Ganghyeok-Lim/Proj-ZYNQ-7000_SOM_Bd/Rev_A/01_HW/0. Fab Files/BOM/ZYNQ_SOM_Bd_BOM_240518.xlsx

Comment | Description | Designator | Quantity | LCSC Part #
470nF/6.3V/0603 | 6.3V 470nF X5R ±10% 0201 Multilayer Ceramic Capacitors MLCC - SMD/SMT ROHS | C300, C302, C303, C306, C307, C308, C313, C314, C315, C316, C319, C320, C321, C322, C327, C328, C333, C338, C339, C340, C341, C342, C343, C344, C345, C704, C705, C706, C707, C803, C814, C827, C838 | 33 | C85926
4.7uF/10V/1005 | 10V 4.7uF X5R ±20% 0402 Multilayer Ceramic Capacitors MLCC - SMD/SMT ROHS | C301, C305, C309, C312, C317, C323, C326, C329, C332, C336, C337, C346, C347, C505, C601, C708, C709, C710, C711, C713, C717, C718, C719, C802, C813, C826, C837 | 27 | C23733
100uF/6.3V/3216 | Ceramic CAP_100uF/6.3V/3216 | C304, C310, C311, C318, C324, C325, C330, C331, C334, C335, C348 | 11 | C15008
100nF/16V/1005 | Ceramic CAP_100nF/16V/1005 | C400, C401, C500, C501, C502, C503, C504, C600 | 8 | C1525
47nF/16V/0603 | 16V 47nF X5R ±10% 0201 Multilayer Ceramic Capacitors MLCC - SMD/SMT ROHS | C700, C701, C702, C703, C715, C716, C800, C801, C804, C805, C806, C807, C808, C809, C810, C811, C812, C815, C816, C817, C818, C819, C820, C821, C822, C823, C824, C825, C828, C829, C830, C831, C832, C833, C834, C835, C836, C839, C840, C841, C842, C843, C844, C845, C846, C847 | 46 | C88917
22uF/25V/2012 | Ceramic CAP_22uF/25V/2012 | C712, C714 | 2 | C45783
100nF/50V/1608 | Ceramic CAP_100nF/50V/1608 | C901, C903, C905, C907, C913 | 5 | C14663
10uF/25V/1608 | Ceramic CAP_10uF/25V/1608 | C908, C909, C910, C911, C914 | 5 | C96446
TC2070-IDC | TC2070 14-pin Plug-of-Nails™ (with legs) to 14 pin 2mm female IDC connector. | CN400 | 1
EDGE-CONNECTOR_SODIMM-260P | EDGE-CONNECTOR_DDR4-SODIMM-260P | CN900 | 1
CG0402MLU-3.3G | Varistor 1 Circuit Surface Mount, MLCV 0402 (1005 Metric) | ESD400, ESD401, ESD402, ESD403 | 4 | C2655393
BLM15PX121SN1D | 55mΩ ±25% 120Ω@100MHz 0402 Ferrite Beads ROHS | FB300 | 1 | C88970
GREEN/2012 | Colorless transparence -30℃~+85℃ Positive post Common anode RGB 120° 0805 Light Emitting Diodes (LED) ROHS | LED400, LED900 | 2 | C2962094
RGB/2012 | Colorless transparence -30℃~+85℃ Positive post Common anode RGB 120° 0805 Light Emitting Diodes (LED) ROHS | LED501, LED600 | 2 | C2962094
2N7002 | 60V 115mA 200mW 7.5Ω@10V,500mA N Channel SOT-23 MOSFETs ROHS | Q400 | 1 | C8545
4.7K/1005 | RES_4.7K/1005/62.5mW | R400, R401, R402, R403, R404, R505, R726 | 7 | C25900
22R/1005 | RES_22R/1005/62.5mW | R405, R406, R407, R408, R500, R502, R600 | 7 | C25092
510R/1005 | RES_510R/1005/62.5mW | R409, R910 | 2 | C25123
0R/1608/NC | 0R/1608/0.1W/NC | R410, R411 | 2
20K/1005 | RES_20K/1005/62.5mW | R412, R413, R414, R415, R416, R513, R515 | 7 | C25765
1K/1608 | RES_1K/1608/0.1W | R417, R418 | 2 | C21190
1K/1005 | RES_1K/1005/62.5mW | R419, R420, R421, R604, R728 | 5 | C11702
12K/1005 | RES_12K/1005/62.5mW | R422, R501, R504, R725 | 4 | C25752
120R/1005 | RES_120R/1005/62.5mW | R503 | 1 | C25079
470R/1005 | RES_470R/1005/62.5mW | R508, R510, R512, R601, R602, R603 | 6 | C25117
0R/1005/NC | RES_0R/1005/62.5mW/NC | R509 | 1
20K/1005/NC | RES_20K/1005/62.5mW/NC | R511, R514 | 2
100R/1005 | RES_100R/1005/62.5mW | R700, R727, R729 | 3 | C25076
49.9R/1005 | RES_49.9R/1005/62.5mW | R701, R702, R703, R704, R705, R706, R707, R708, R709, R710, R711, R712, R713, R714, R715, R716, R717, R718, R719, R720, R721, R722, R723, R724 | 24 | C25120
100K/1005 | RES_100K/1005/62.5mW | R730 | 1 | C25741
240R/1608 | RES_240R/1608/0.1W | R800, R801 | 2 | C23350
0R/1005 | RES_0R/1005/62.5mW | R900, R901, R902, R903, R904, R905, R906, R907, R908, R909 | 10 | C17168
TS-1088-AR02016 | NO 50mA 100MΩ 100000 Times 12V 160gf@±50gf Brick nogging SPST SMD Tactile Switches ROHS | SW400, SW500 | 2 | C720477
DSHP04TS-S | 4Bit SPST 24V 25mA Black 3千次 Slide (Standard),凹槽式 SMD-8P,5.4x6.7mm DIP Switches ROHS | SW401 | 1 | C319050
XC7Z010-1CLG400I | Dual ARM® Cortex®-A9 MPCore™ with CoreSight™ System On Chip (SOC) IC Zynq®-7000 Artix™-7 FPGA, 28K Logic Cells 766MHz 400-CSPBGA (17x17) | U300 | 1 | C2840994
W25Q128JVEIQ | 3V 128M-BIT SERIAL FLASH MEMORY WITH DUAL/QUAD SPI & QPI & DTR WSON-8 | U500 | 1 | C401662
SN74LVC1G07DBVT | Single Buffer/Driver With Open-Drain Output / IC BUF NON-INVERT 5.5V SOT23-5 | U502 | 1 | C2867373
BD3539FVM-TR | 1.0V to 5.5V, 1A 1ch Termination Regulators for DDR-SDRAMs, 8-MSOP | U701 | 1 | C213437
MT41K256M16TW-107 IT:P | SDRAM - DDR3L Memory IC 4Gbit Parallel 933 MHz 20 ns 96-FBGA (8x14) | U800, U801 | 2 | C367428
S2D33.333300B20F30T(33.33MHz) | 3.3V ±20ppm CMOS 33.3333MHz SMD2520-4P Oscillators ROHS | X500 | 1 | C907622
S2D50.000000B20F30T(50MHz) | 3.3V 20mA ±30ppm CMOS 50MHz SMD2520-4P Oscillators ROHS | X600 | 1 | C907626
