Ganghyeok-Lim/Proj-ZYNQ-7000_SOM_Bd/Rev_A/01_HW/ZYNQ-7000 SOM Bd/ZYNQ-7000 SOM Bd.pdf

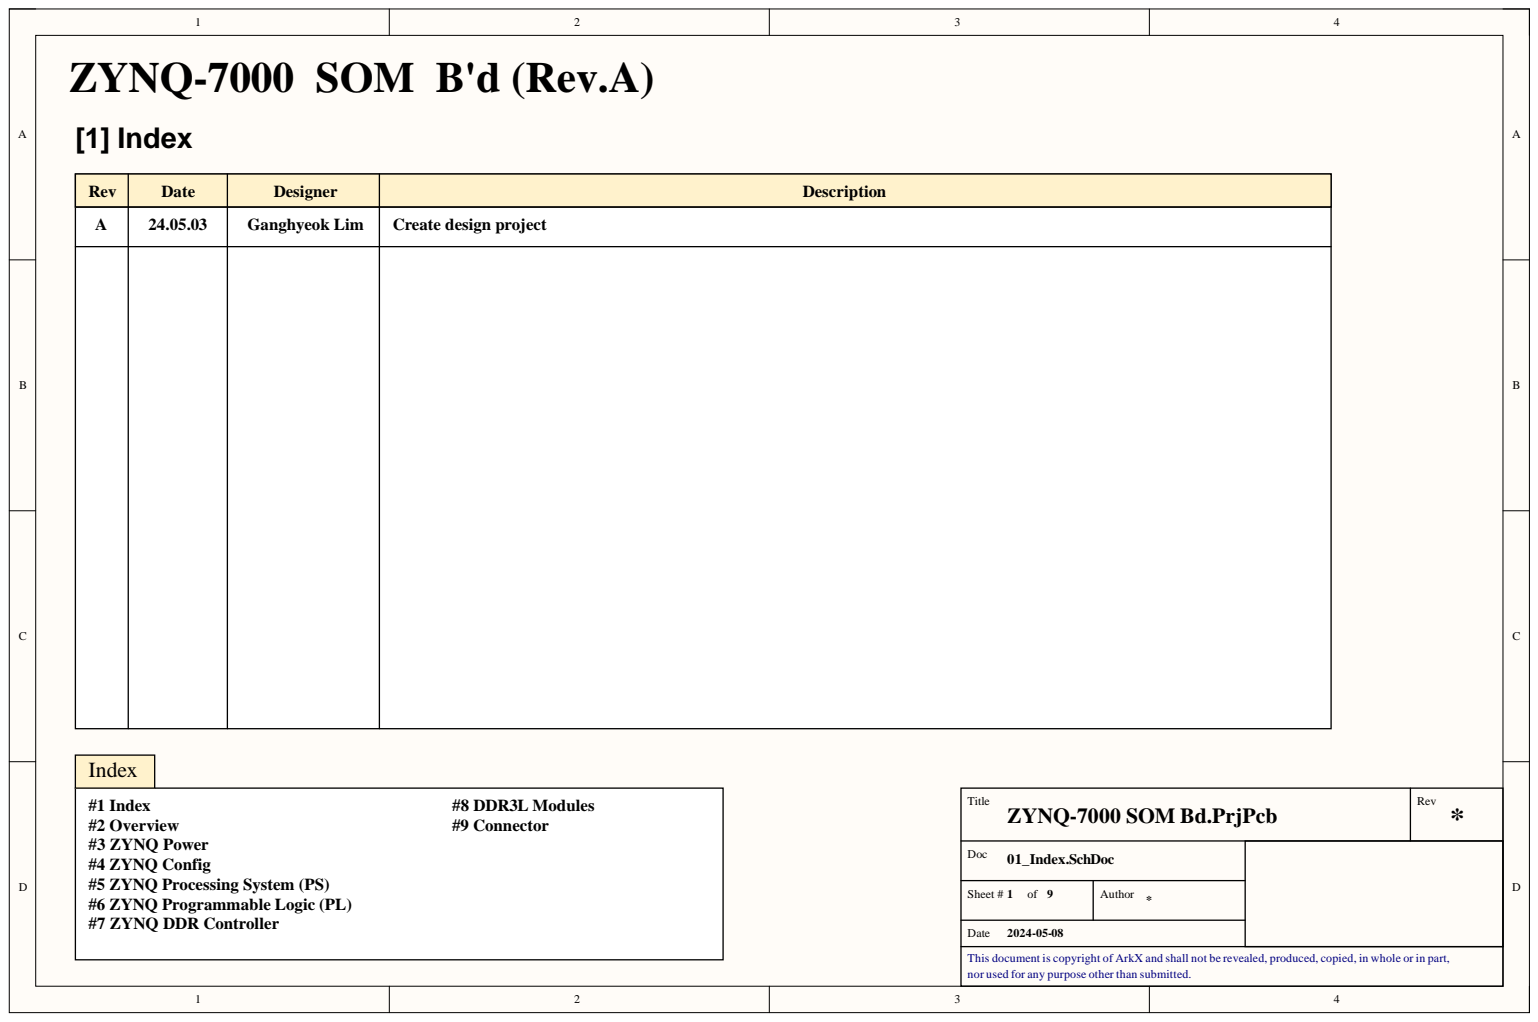
[picture p1: page 1]

Rev | Date | Designer | Description

A | 24.05.03 | Ganghyeok Lim | Create design project

#1 Index
#2 Overview
#3 ZYNQ Power
#4 ZYNQ Config
#5 ZYNQ Processing System (PS)
#6 ZYNQ Programmable Logic (PL)
#7 ZYNQ DDR Controller

Doc 01_Index.SchDoc

Sheet # 1 of 9 | Author *

This document is copyright of ArkX and shall not be revealed, produced, copied, in whole or in part,
nor used for any purpose other than submitted.

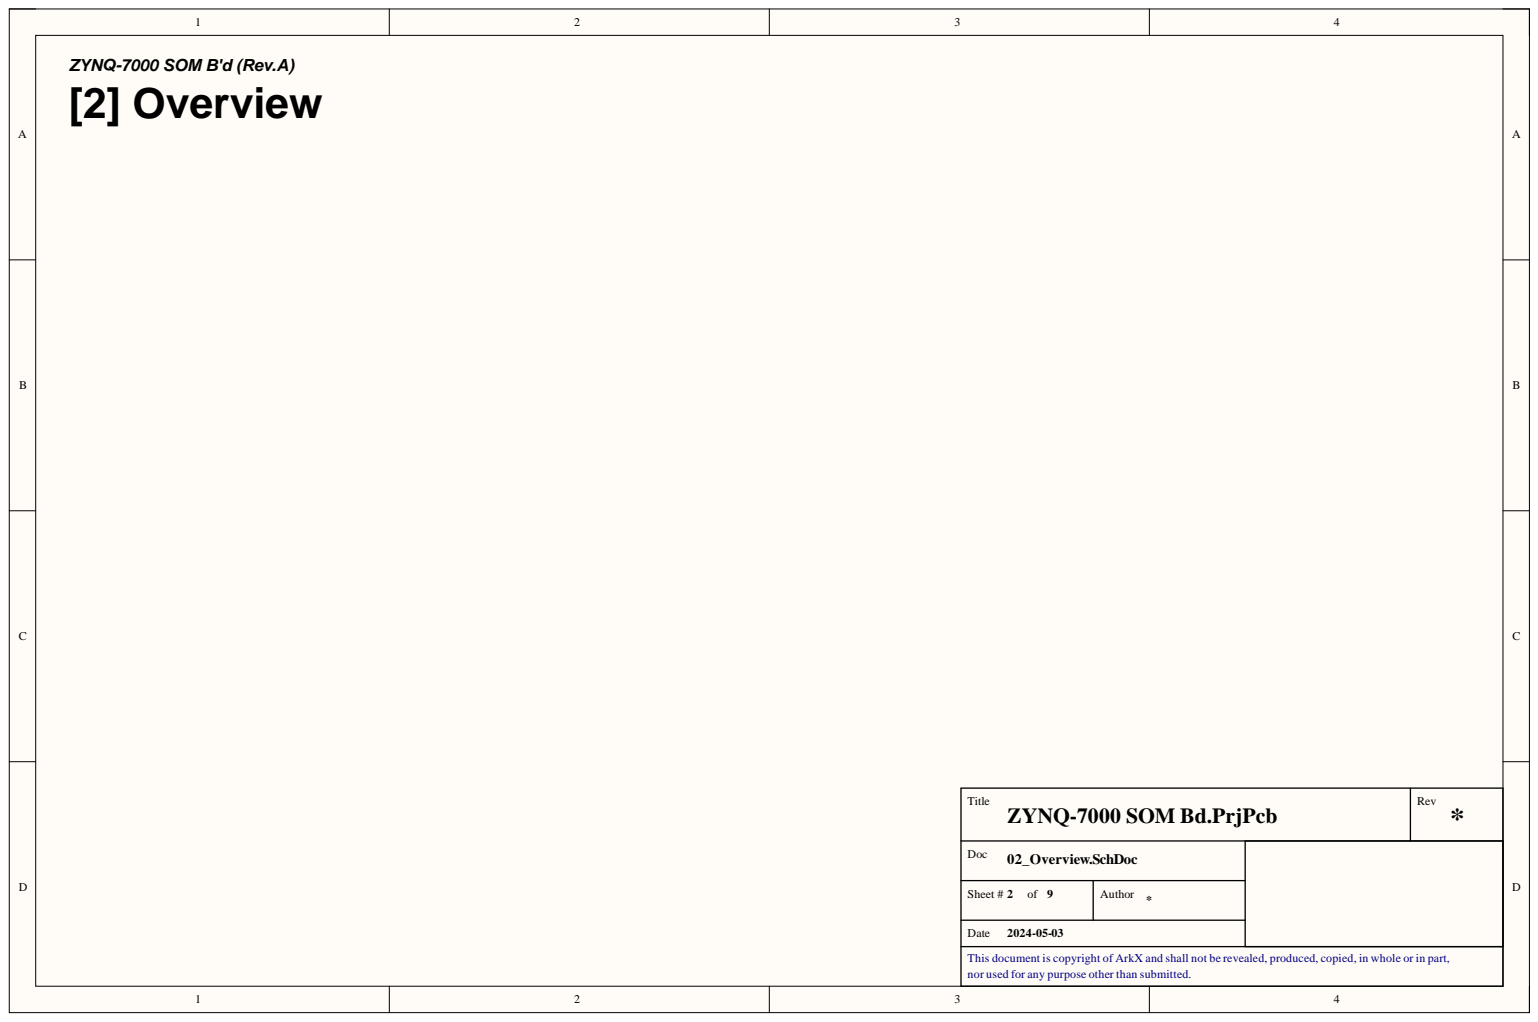
[picture p2: page 2]

Title ZYNQ-7000 SOM Bd.PrjPcb | Rev *

Doc 02_Overview.SchDoc

Sheet # 2 of 9 | Author *

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

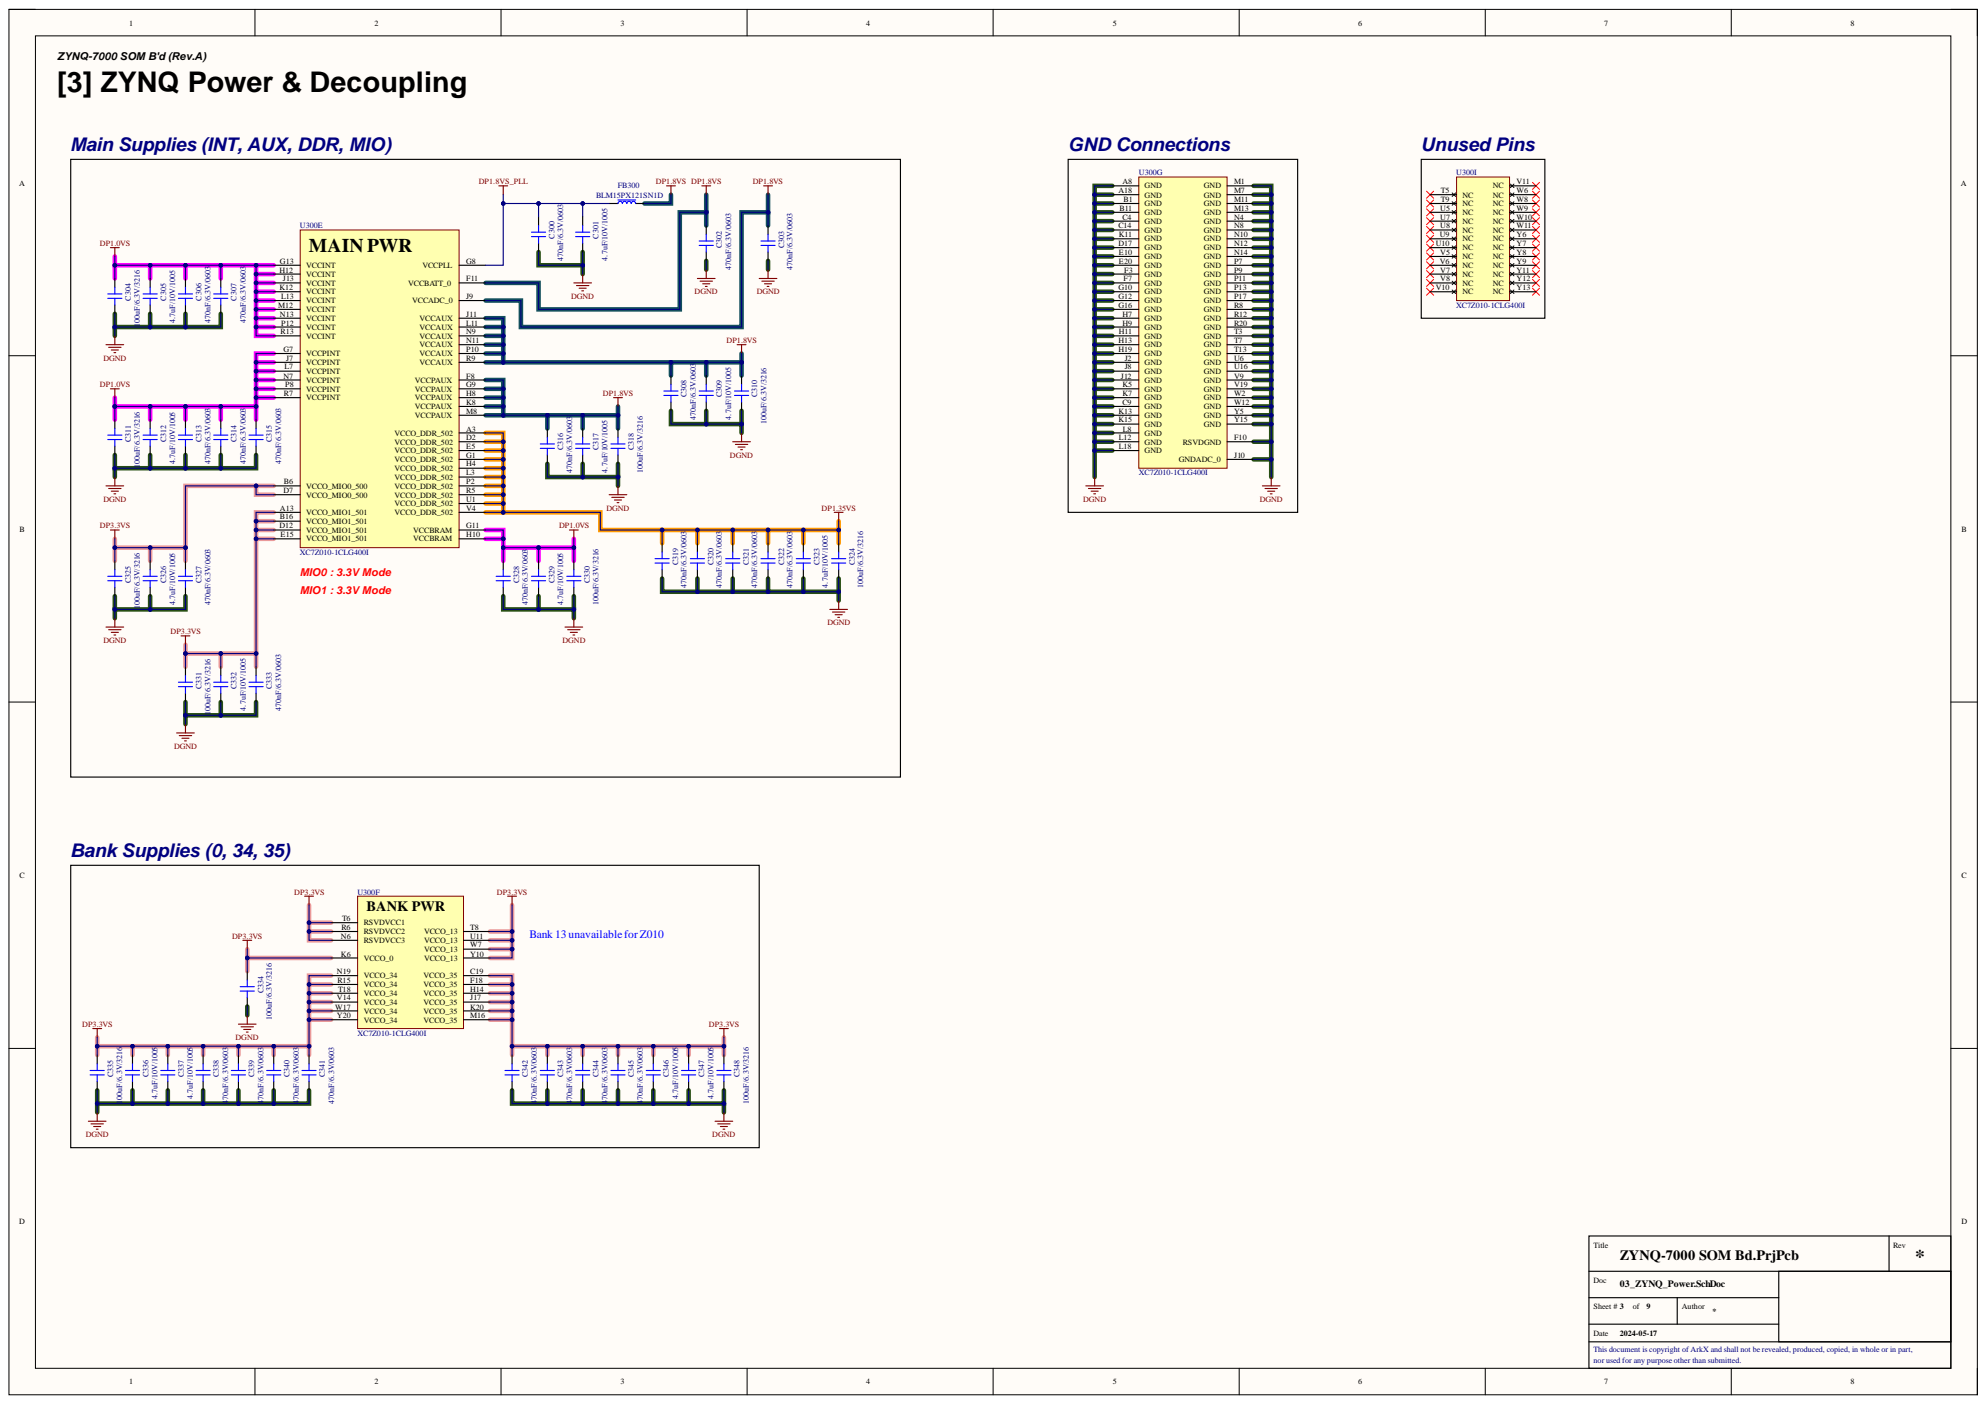
[picture p3: page 3]

Main Supplies (INT, AUX, DDR, MIO)

Title ZYNQ-7000 SOM Bd.PrjPcb | Rev *

Doc 03_ZYNQ_Power.SchDoc

Sheet # 3 of 9 | Author *

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

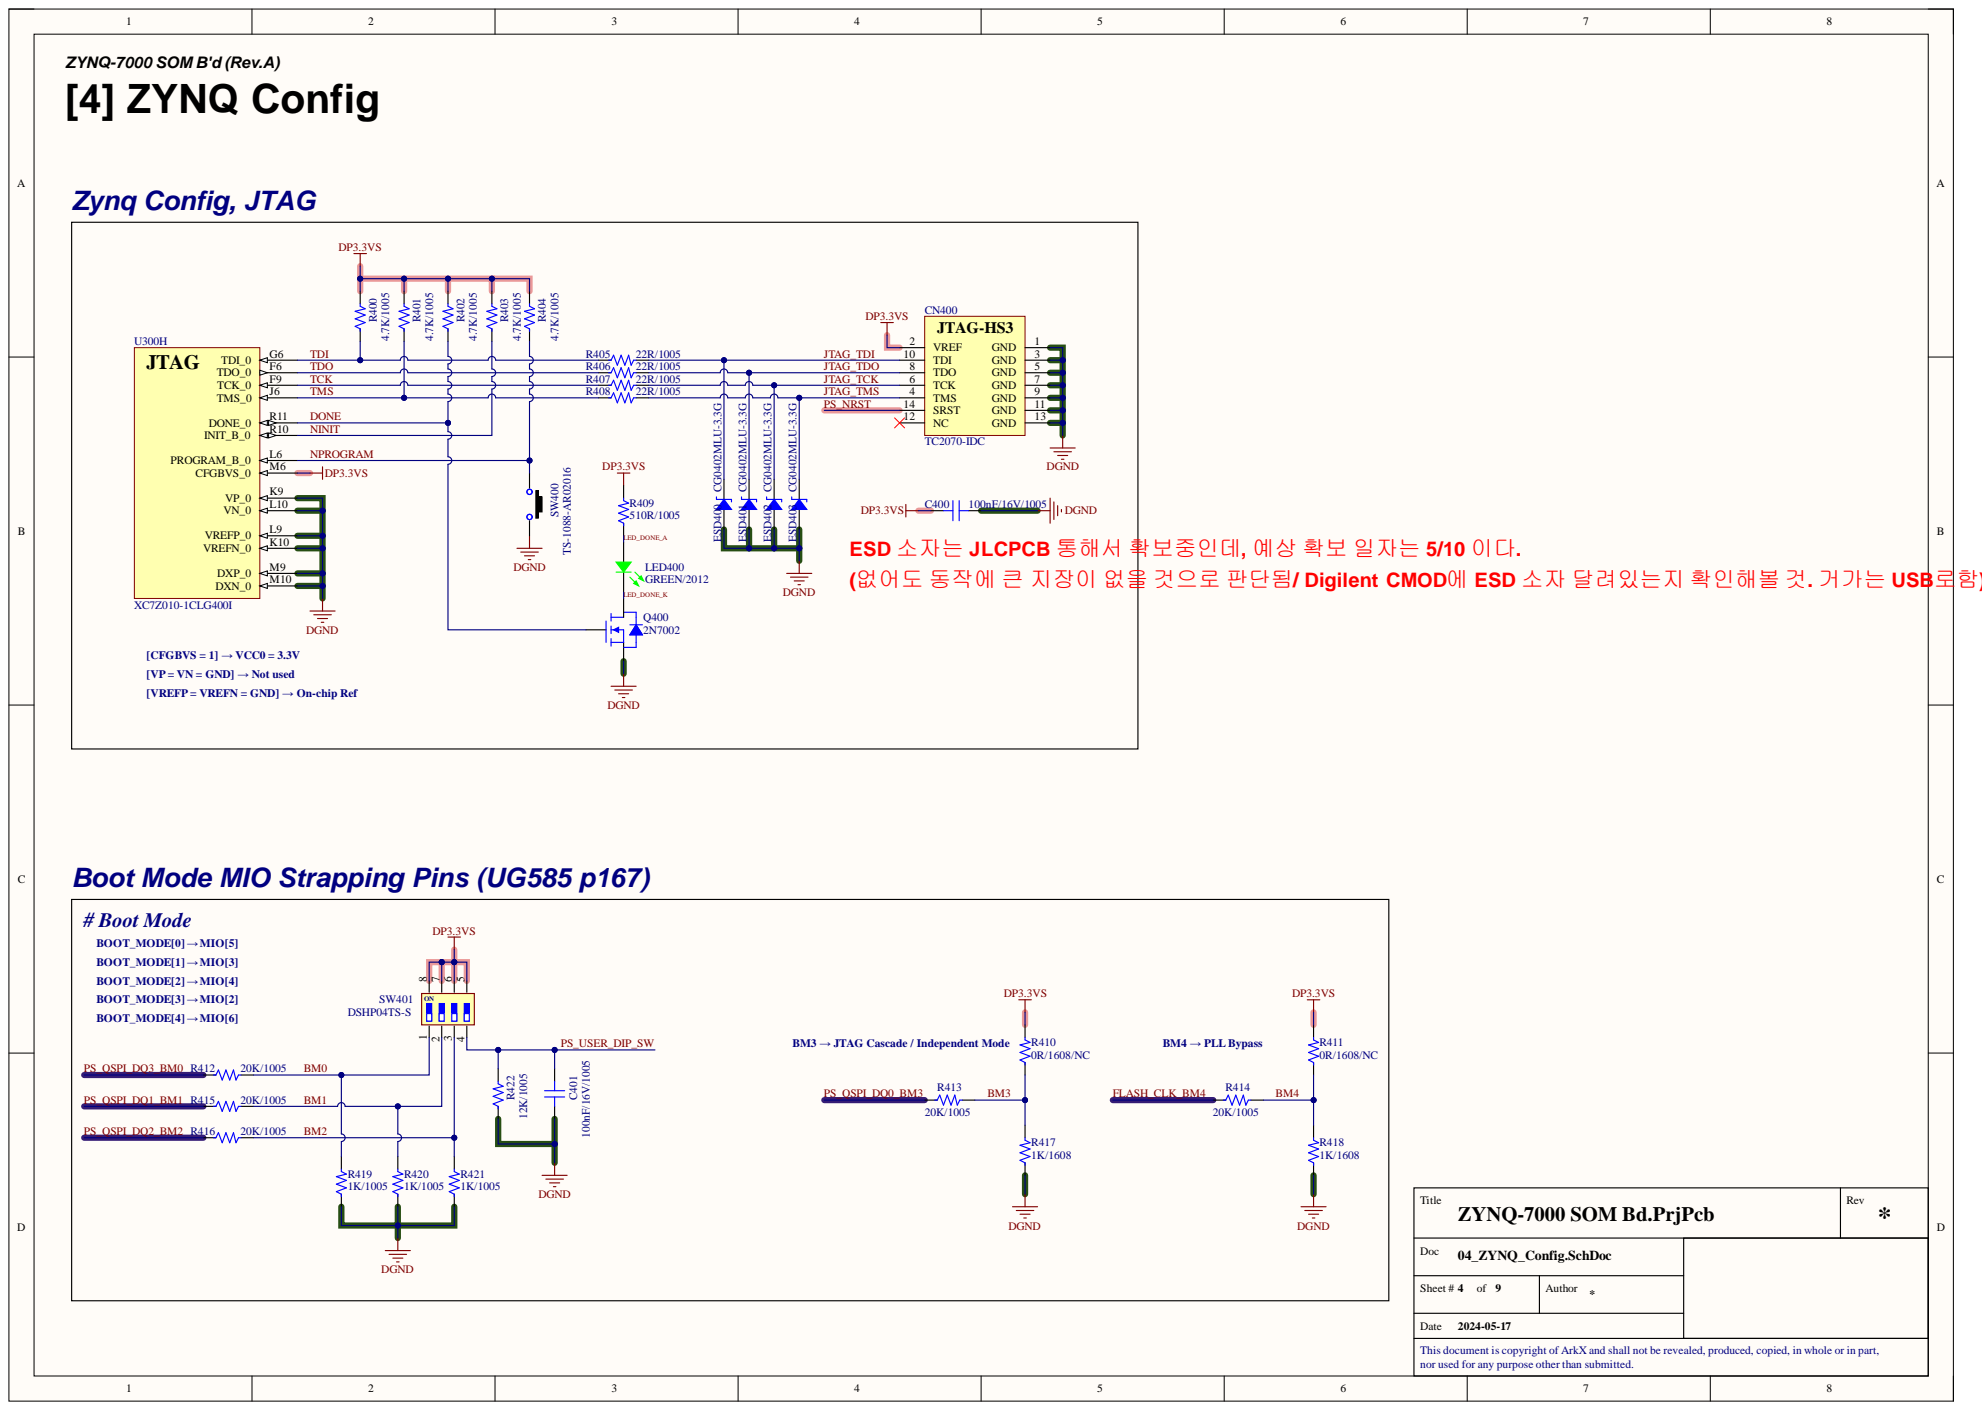
[picture p4: page 4]

ESD 소자는 JLCPCB 통해서 확보중인데, 예상 확보 일자는 5/10 이다.
(없어도 동작에 큰 지장이 없을 것으로 판단됨/ Digilent CMOD에 ESD 소자 달려있는지 확인해볼 것. 거가는 USB로함)

[CFGBVS = 1] → VCC0 = 3.3V
[VP = VN = GND] → Not used
[VREFP = VREFN = GND] → On-chip Ref

Boot Mode MIO Strapping Pins (UG585 p167)

Title ZYNQ-7000 SOM Bd.PrjPcb | Rev *

Doc 04_ZYNQ_Config.SchDoc

Sheet # 4 of 9 | Author

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

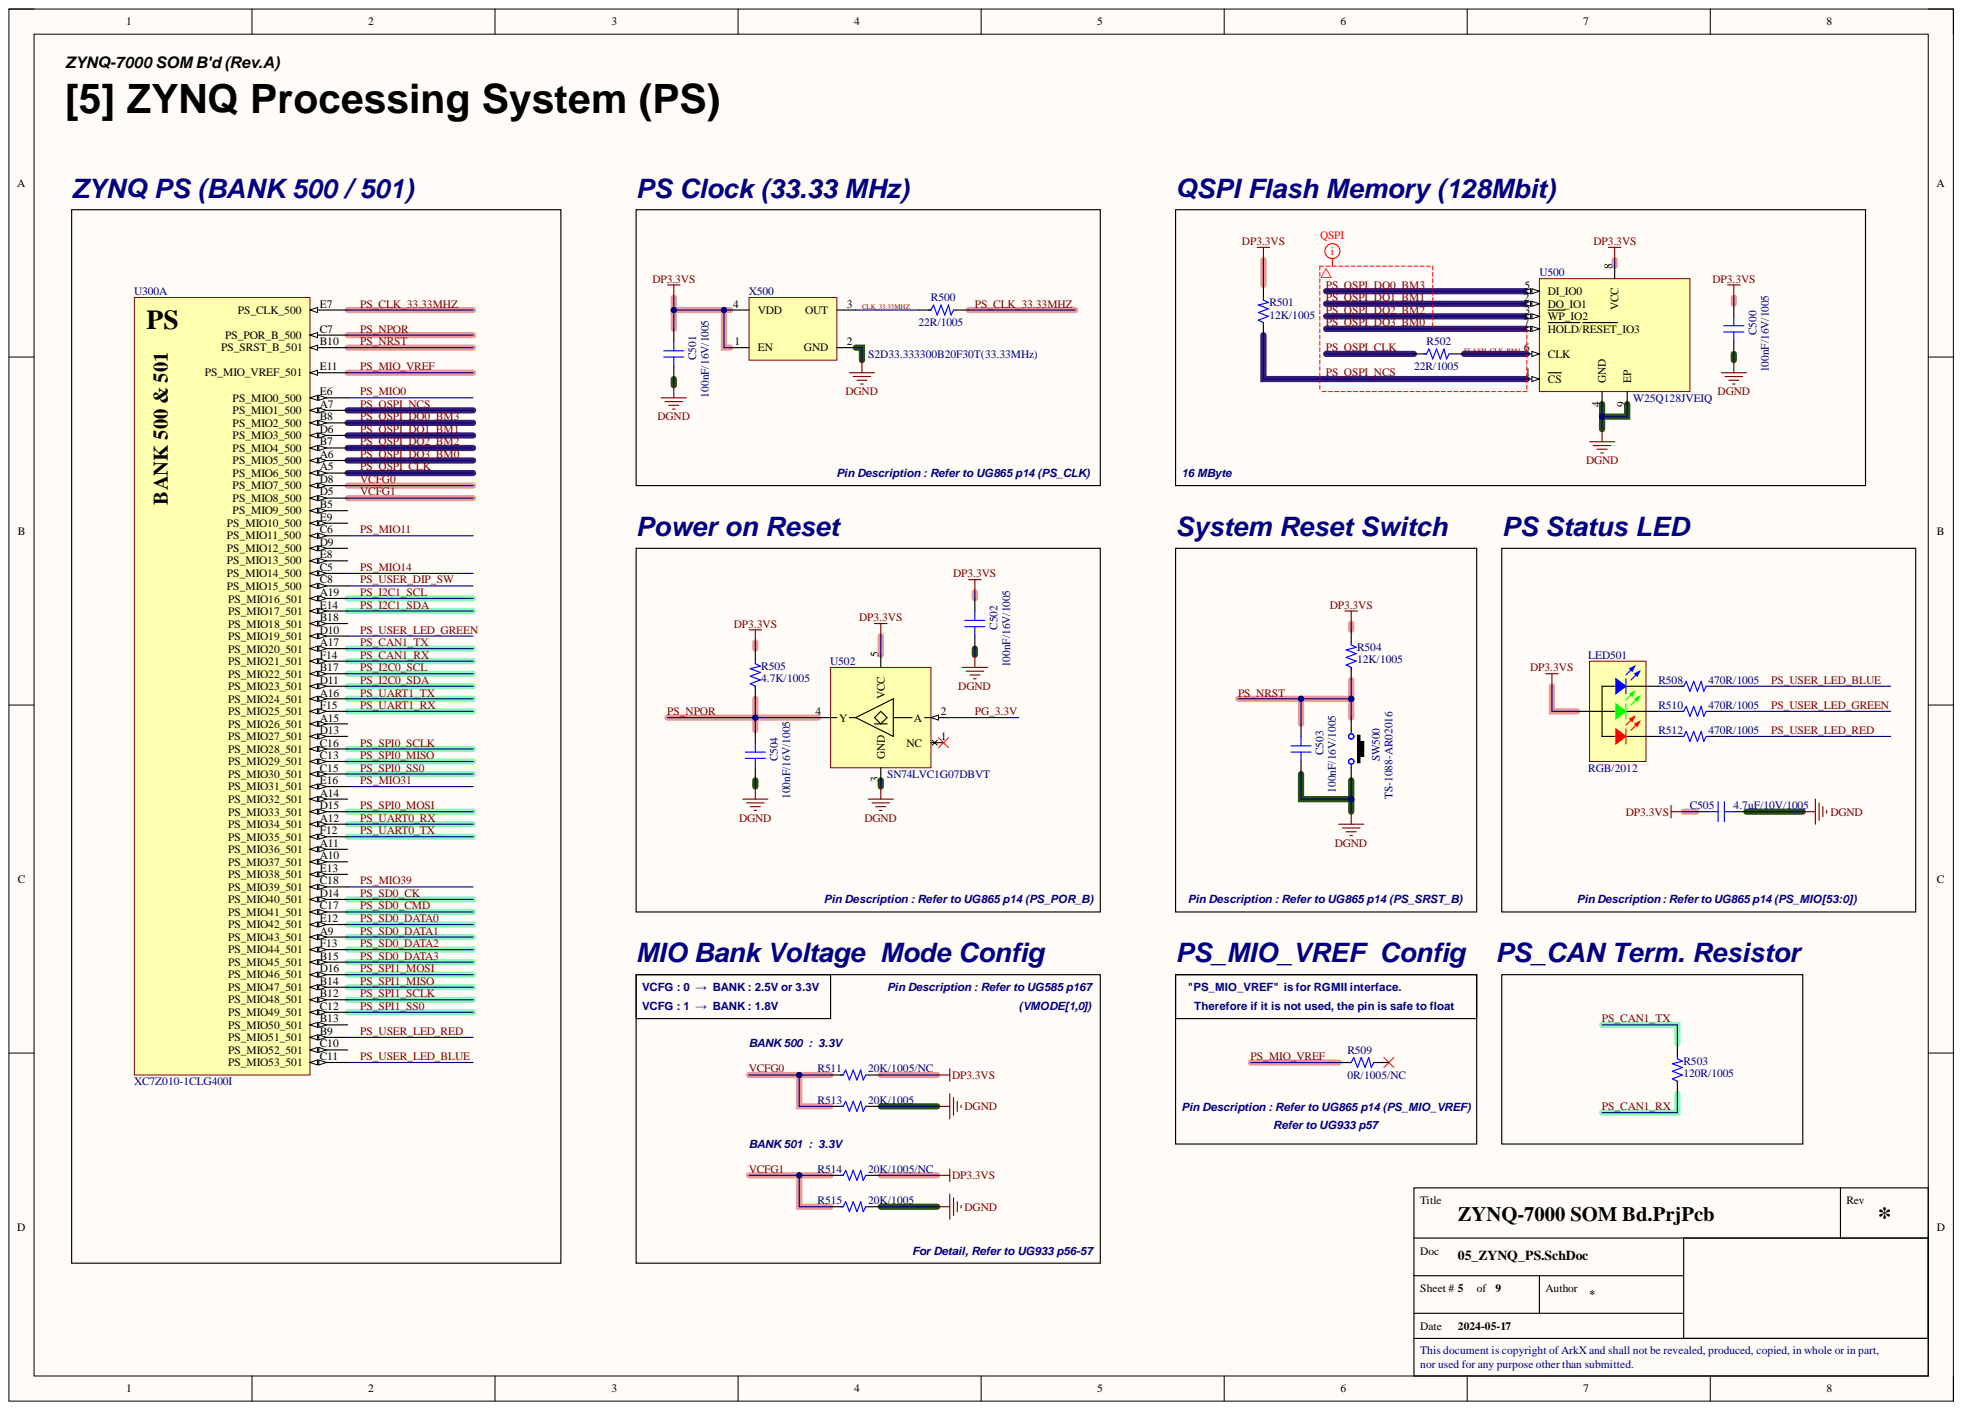
[picture p5: page 5]

[5] ZYNQ Processing System (PS)

PS_QSPI_D Q3_B M 0 | 7
R502 PS_QSPI_C L K F L A S H_CL K_BM 4 22R/100 5 | 6 1

MIO Bank Voltage Mode Config BANK 500 : 3.3V BANK 501 : 3.3V

Ti t l e ZYNQ-7000 SOM Bd.PrjPcb | Rev *

Doc 05_ZY N Q_P S.S c h D o c

Sheet # 5 of 9 | Autho r

s document
for any purpose other

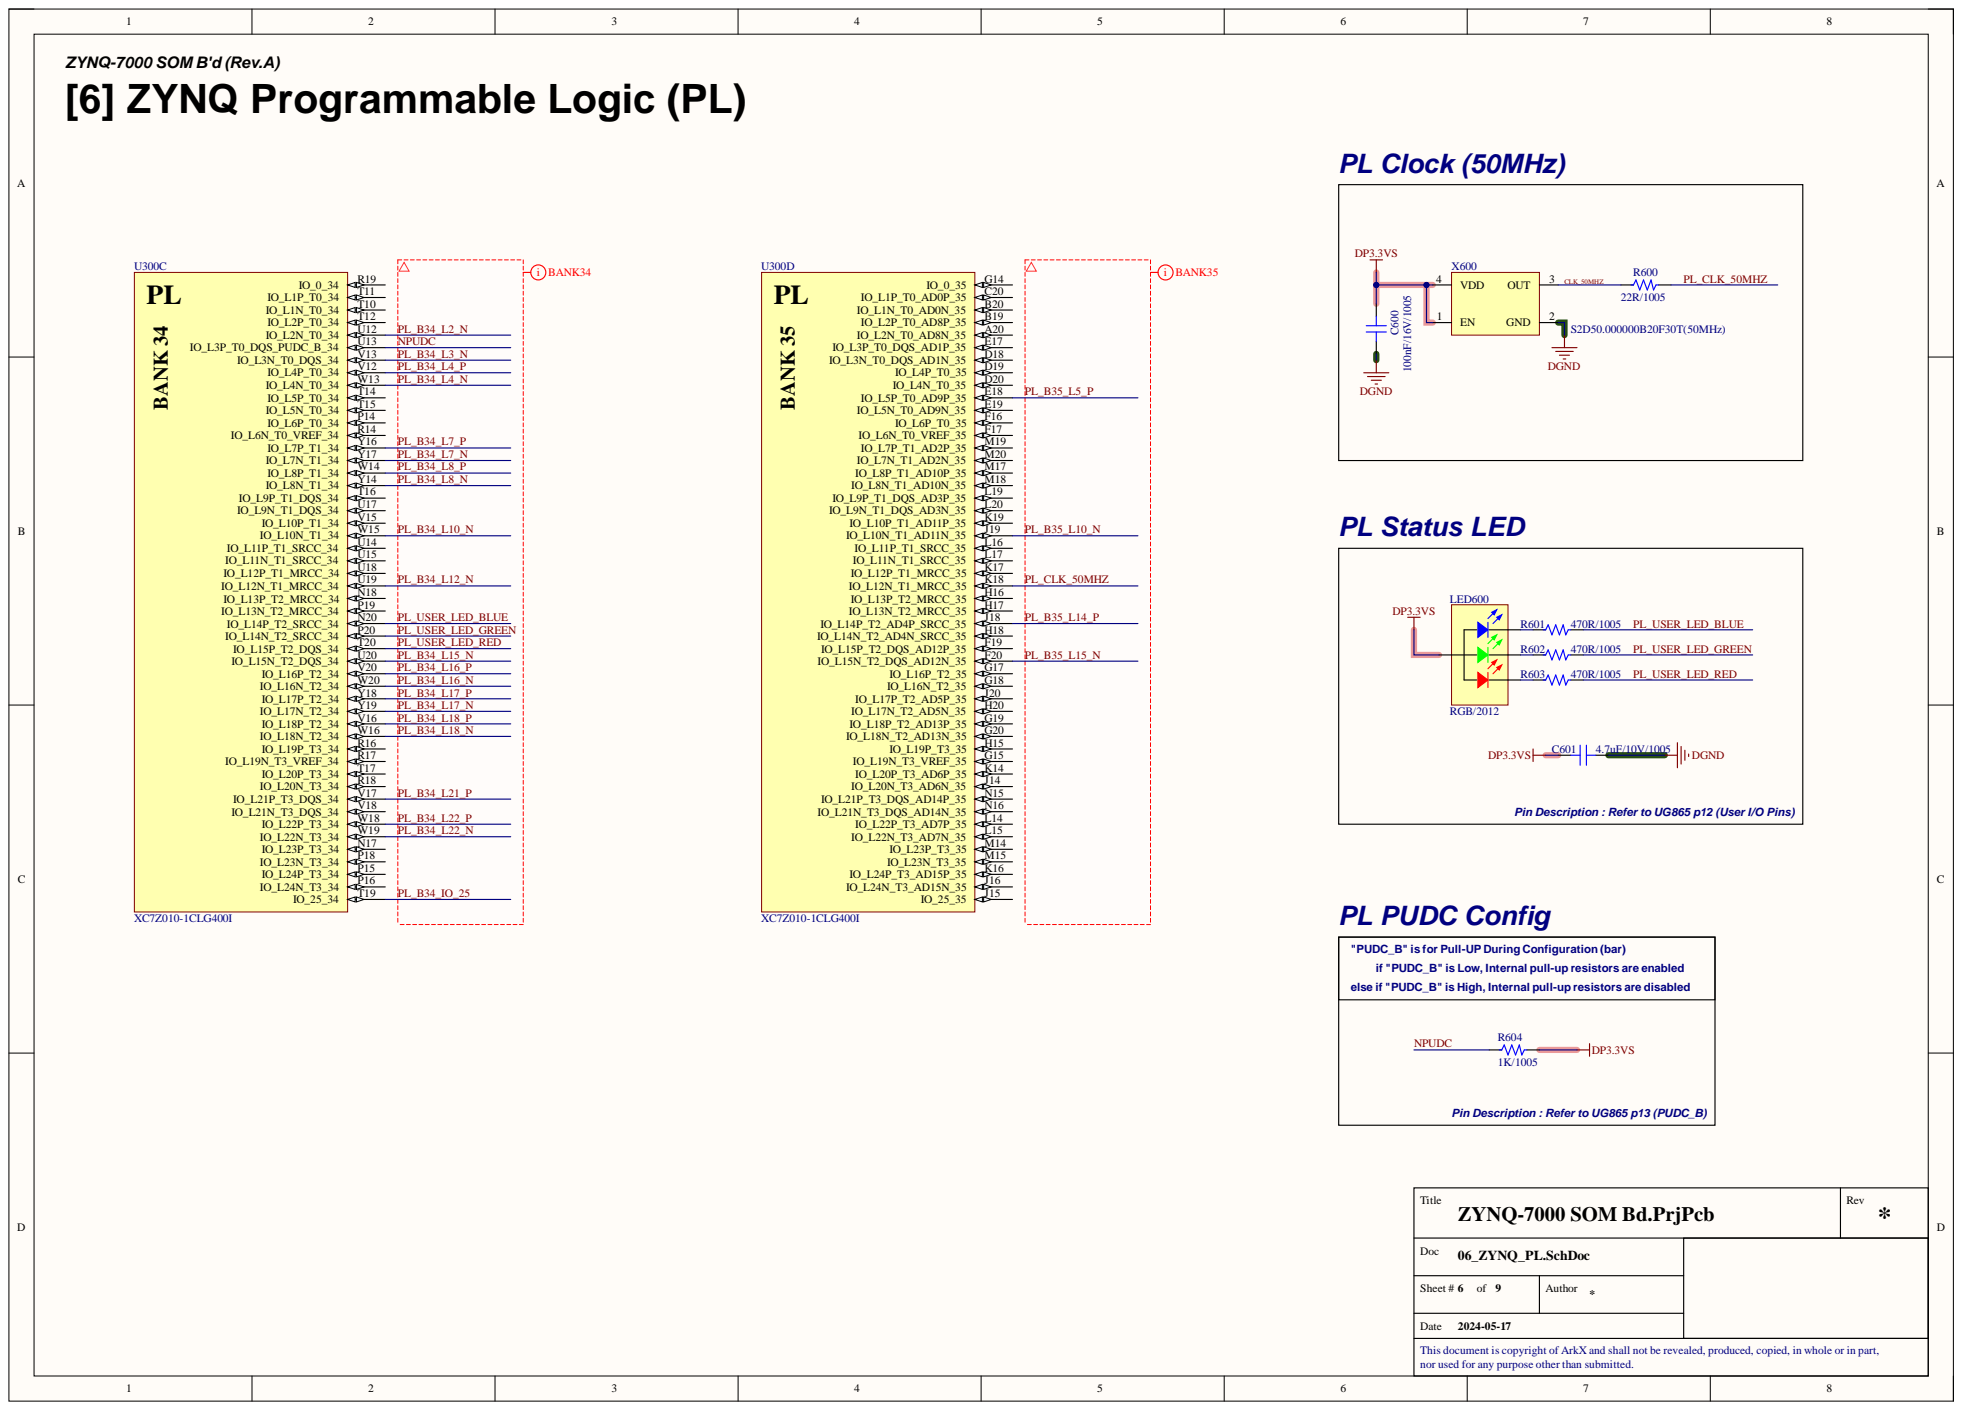
[picture p6: page 6]

[6] ZYNQ Programmable Logic (PL)

PL PUDC Config Pin Description : Refer

Ti t l e ZYNQ-7000 SOM Bd.PrjPcb | Rev *

Doc 06_ZY N Q_PL.S c h D o c

Sheet # 6 of 9 | Autho r

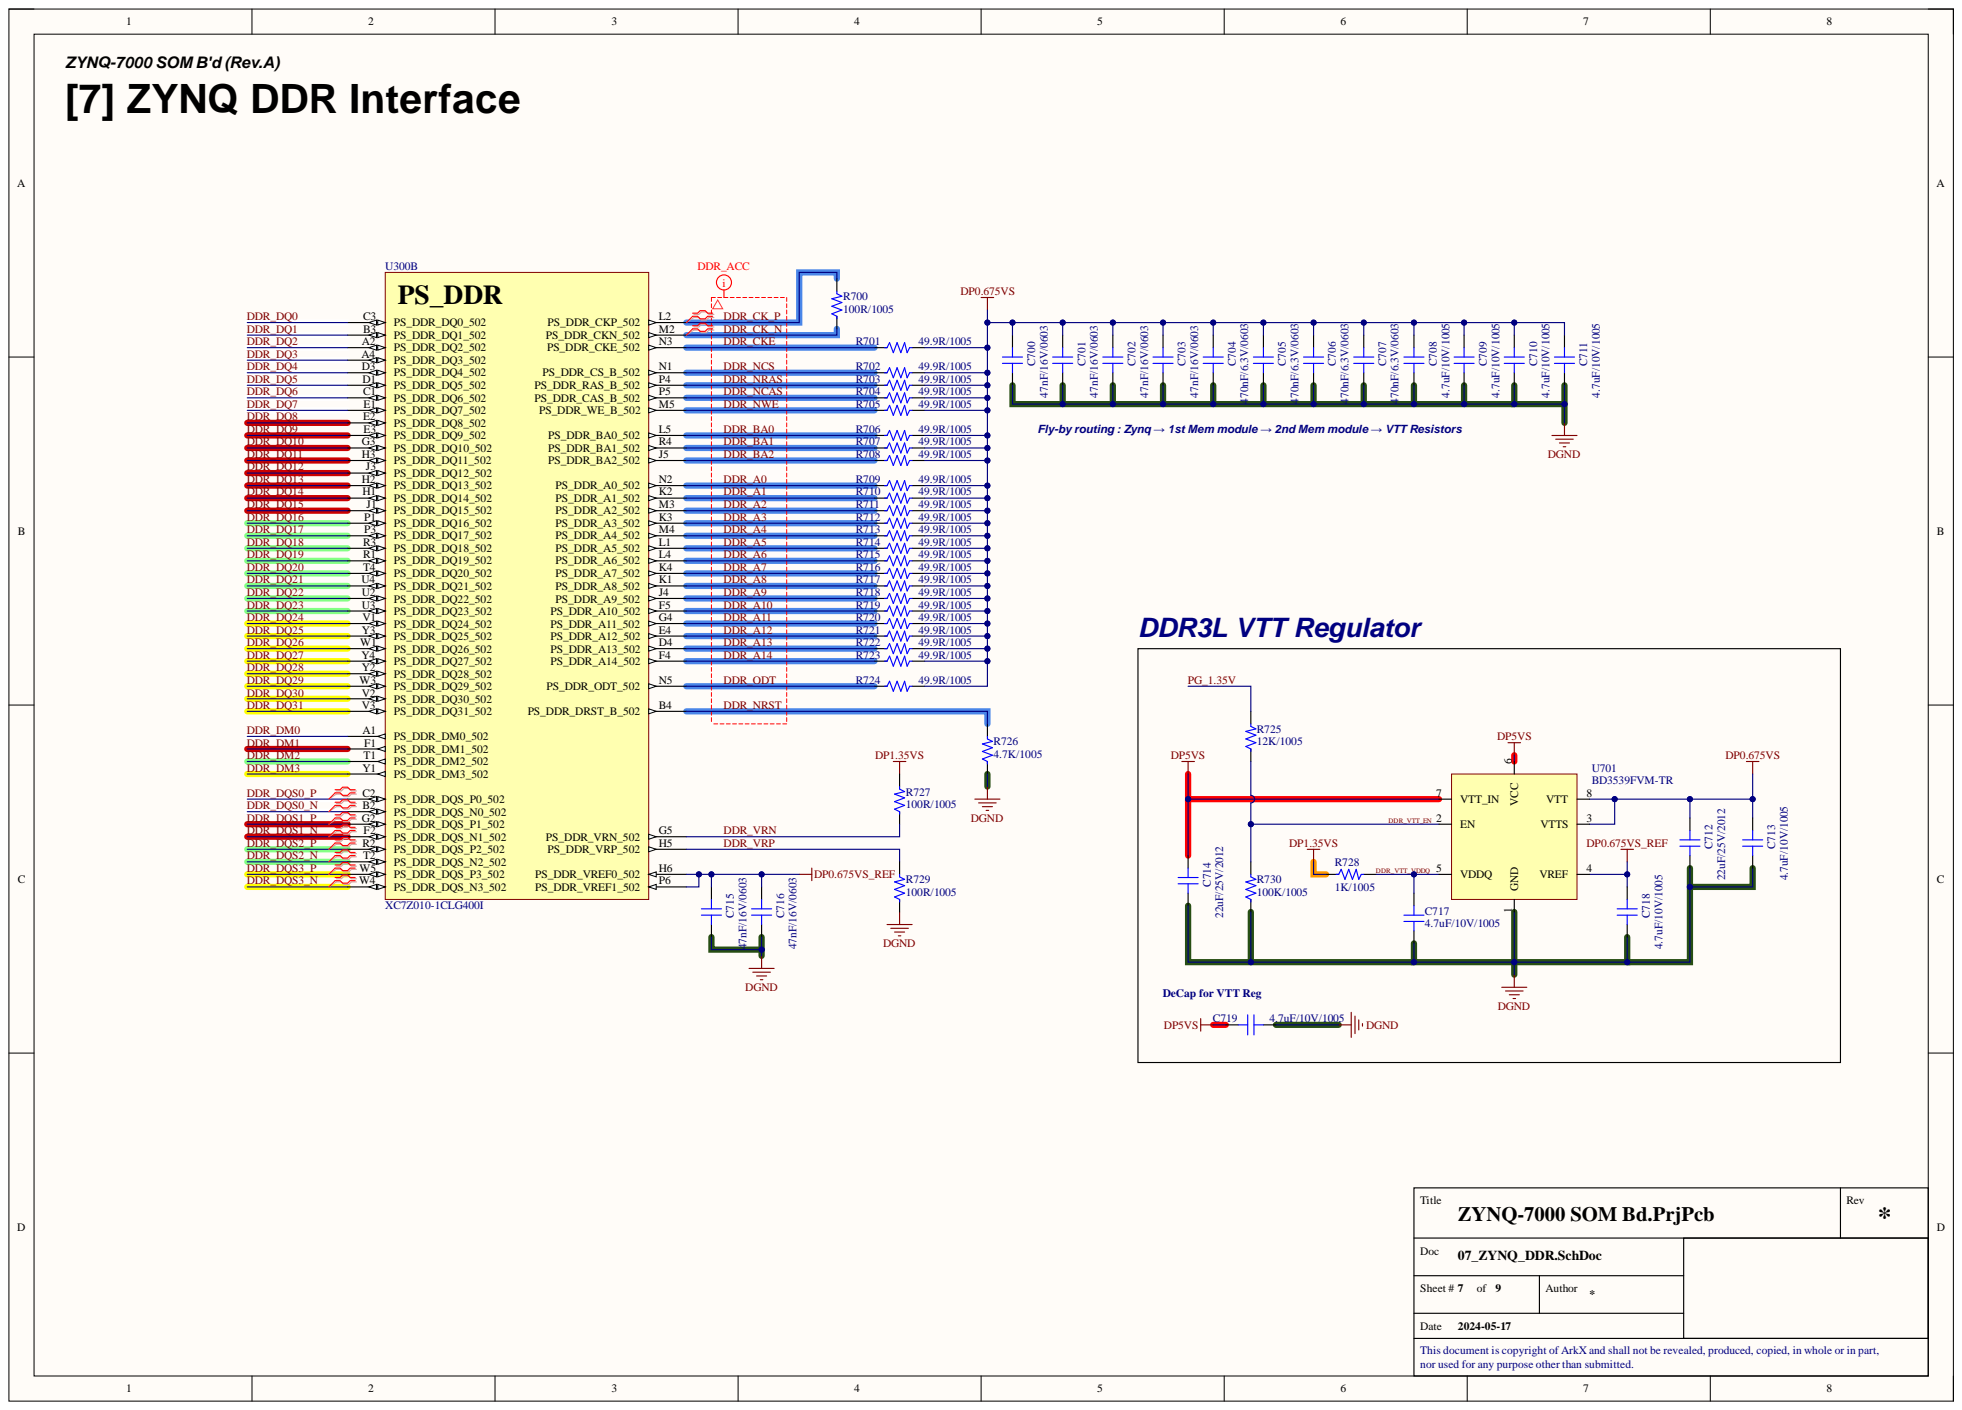
[picture p7: page 7]

M2 PS_DDR_CKP_502 L2 3 PS_DDR_CKN_502 | D D R_C K_N

N P5 PS_DDR_RAS_B_502 P4 PS_DDR_CS_B_502 N1 5 PS_DDR_CAS_B_502 M R4 PS_DDR_BA0_502 L5 5 PS_DDR_BA1_502 J N 5 B 4 | D D R_C KE D D R_N C S D D R_N R A S D D R_N C A S D D R_NWE D D R_B A 0 D D R_B A 1 D D R_B A 2 D D R_A 0 D D R_A 1 D D R_A 2 D D R_A 3 D D R_A 4 D D R_A 5 D D R_A 6 D D R_A 7 D D R_A 8 D D R_A 9 D D R_A10 D D R_A 1 1 D D R_A12 D D R_A13 D D R_A14 D D R_O D T D D R_N RST

Ti t l e ZYNQ-7000 SOM Bd.PrjPcb | Rev *

Doc 07_ZY N Q_D D R.S c h Doc

Sheet # 7 of 9 | Autho r

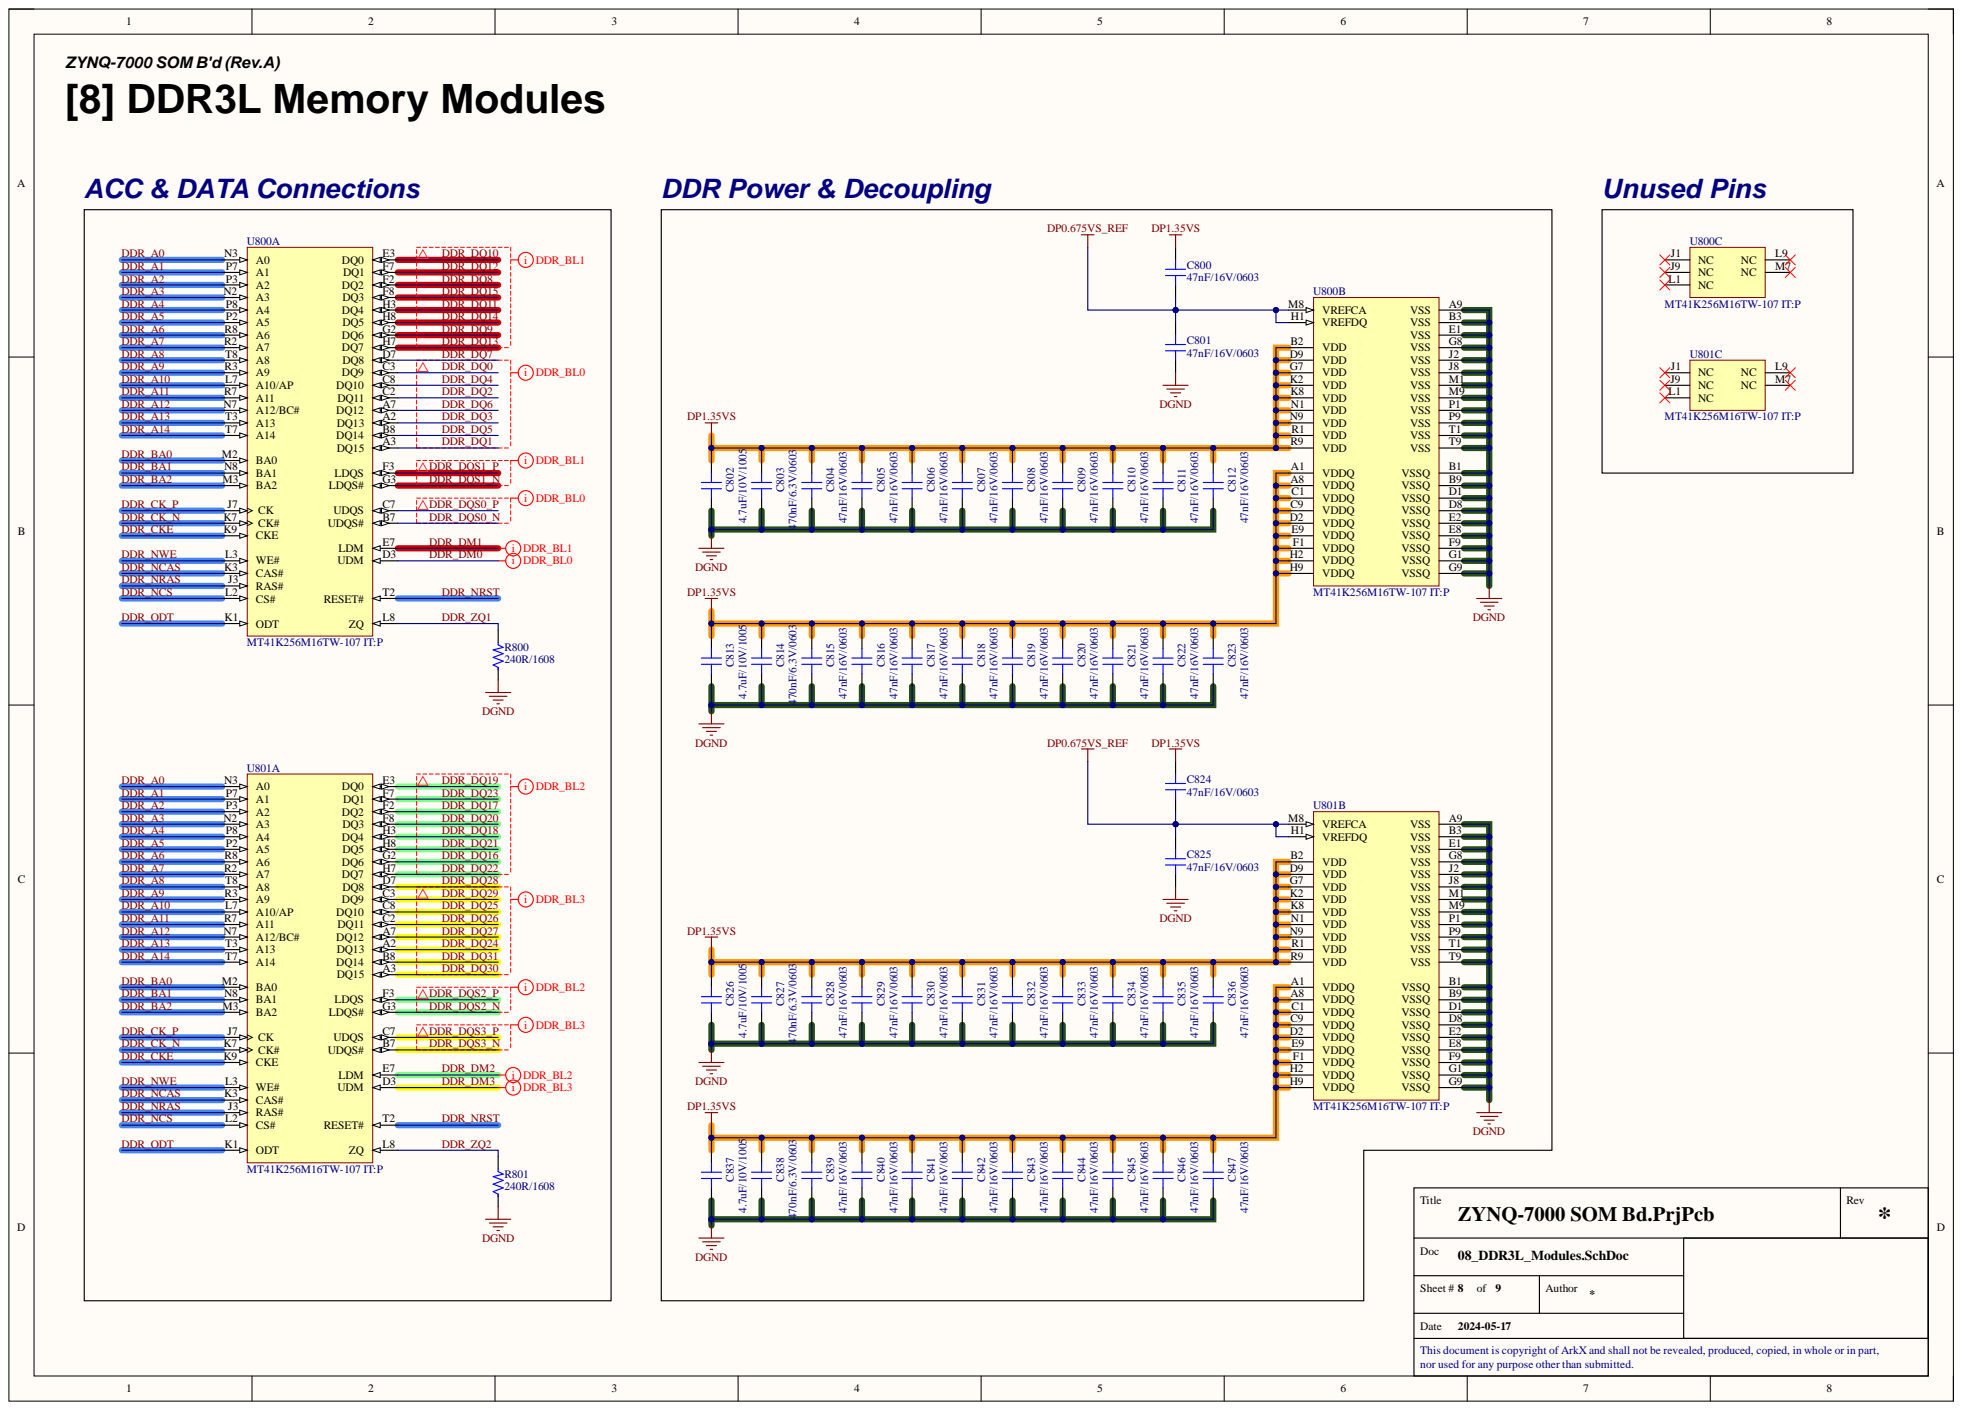
[picture p8: page 8]

C 1 | D 1
C 9 | D 8

Ti t l e ZYNQ-7000 SOM Bd.PrjPcb | Rev *

Doc 08_D D R3L_Mod u l e s.S c h Doc

Sheet # 8 of 9 | Autho r

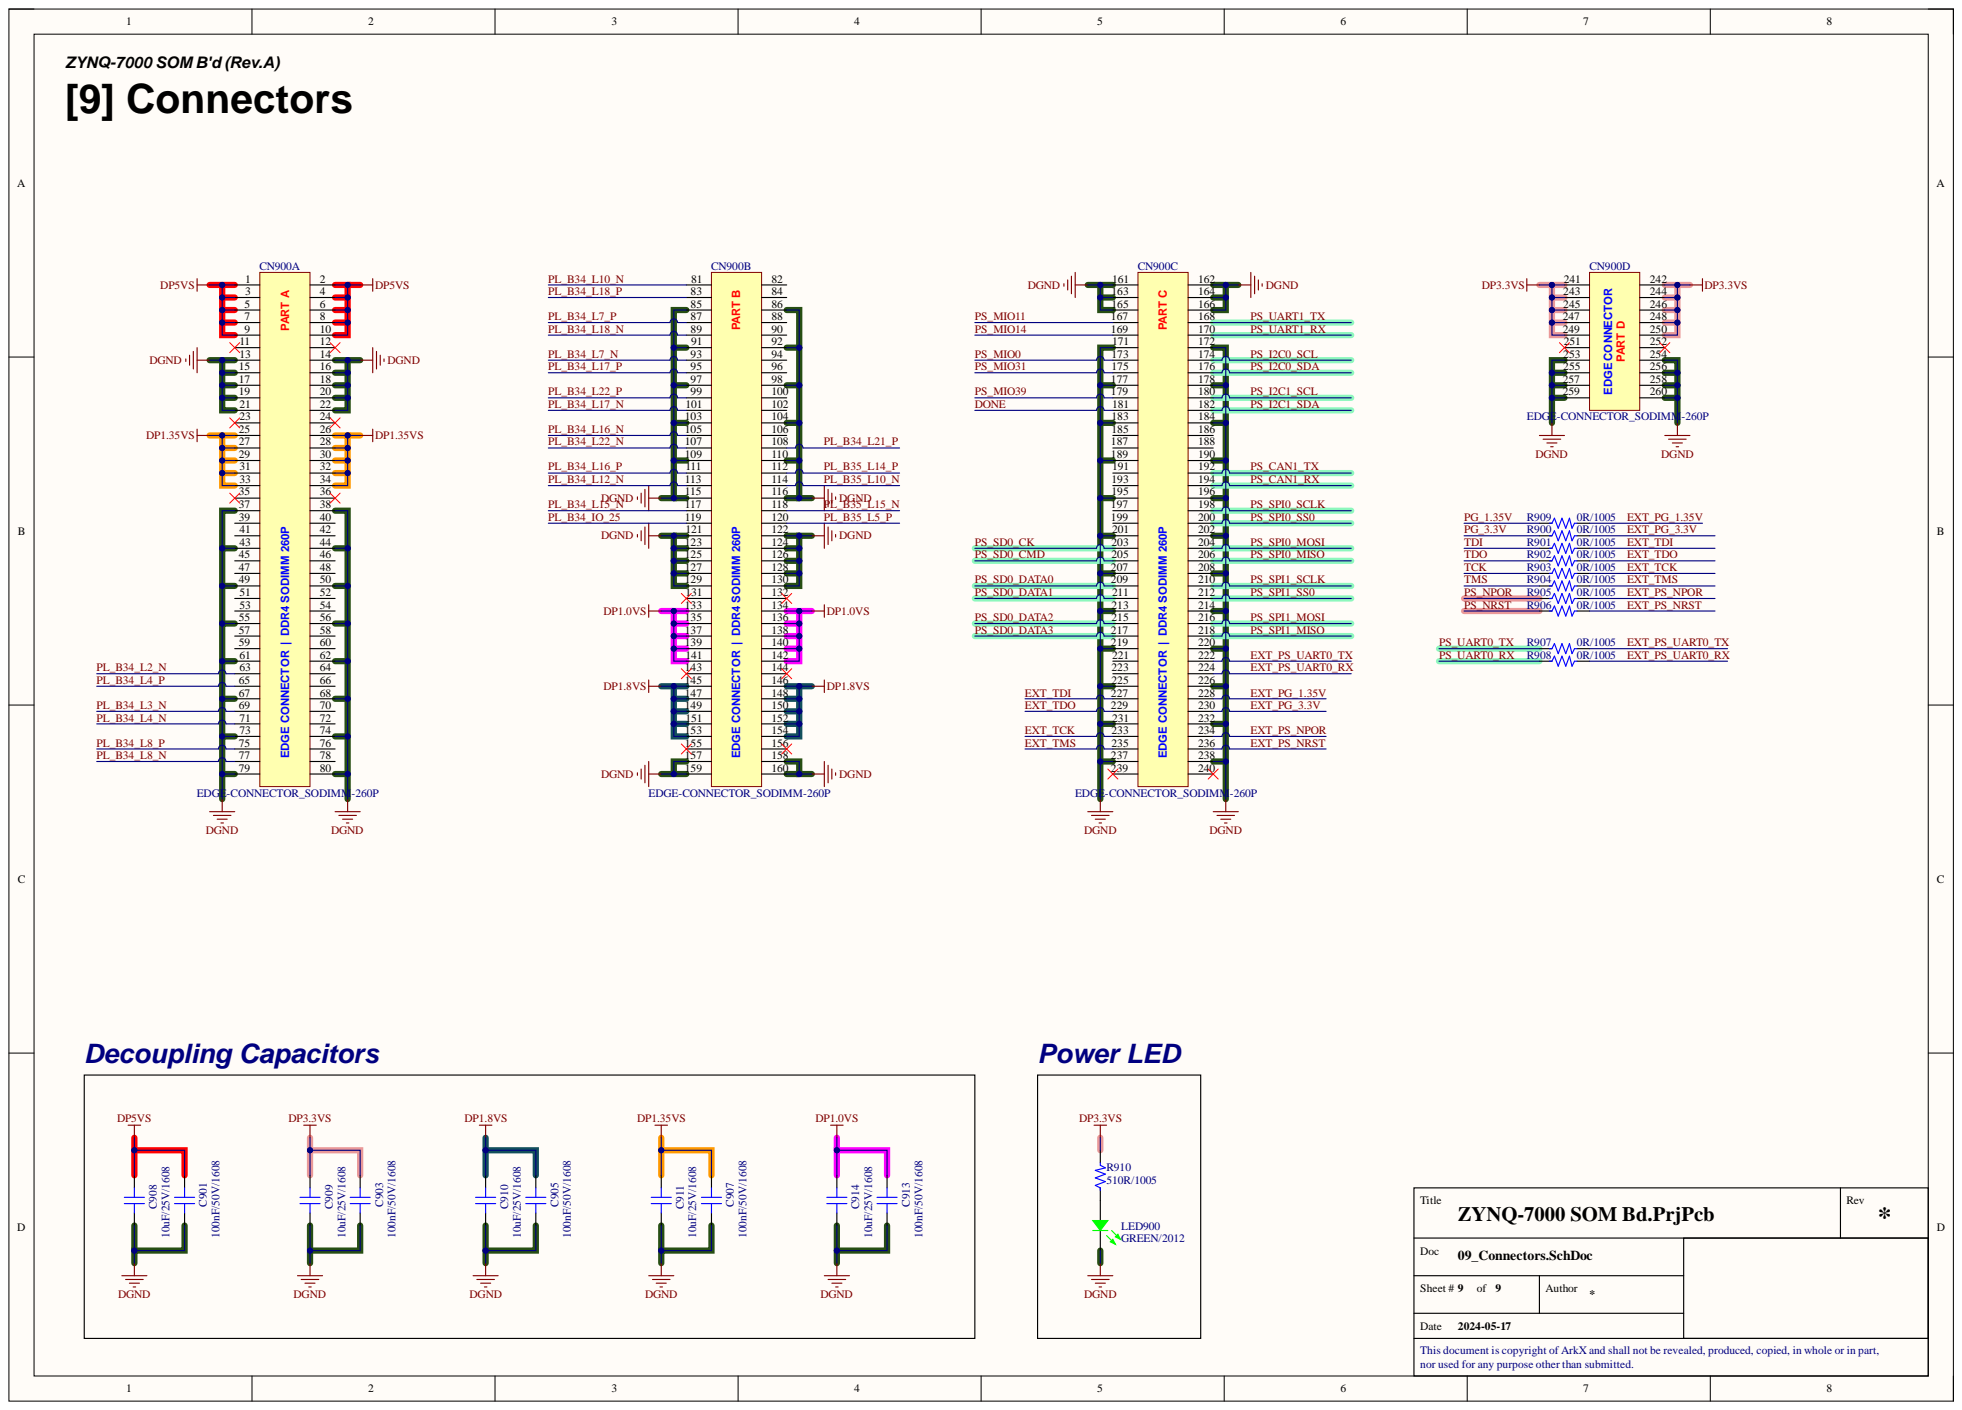
[picture p9: page 9]

PART A EDGE CONNECTOR | DDR4 SODIMM 260P

PART B EDGE CONNECTOR | DDR4 SODIMM 260P

PART C EDGE CONNECTOR | DDR4 SODIMM 260P

Title ZYNQ-7000 SOM Bd.PrjPcb | Rev *

Doc 09_Connectors.SchDoc

Sheet # 9 of 9 | Author

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
