Ganghyeok-Lim/Proj-ZYNQ-7000_SOM_Bd/(list of files, drawings)

Other design files:
Rev_A/01_HW/ZYNQ-7000 SOM Bd/01_Index.SchDoc
Rev_A/01_HW/ZYNQ-7000 SOM Bd/02_Overview.SchDoc
Rev_A/01_HW/ZYNQ-7000 SOM Bd/03_ZYNQ_Power.SchDoc
Rev_A/01_HW/ZYNQ-7000 SOM Bd/04_ZYNQ_Config.SchDoc
Rev_A/01_HW/ZYNQ-7000 SOM Bd/05_ZYNQ_PS.SchDoc
Rev_A/01_HW/ZYNQ-7000 SOM Bd/06_ZYNQ_PL.SchDoc
Rev_A/01_HW/ZYNQ-7000 SOM Bd/07_ZYNQ_DDR.SchDoc
Rev_A/01_HW/ZYNQ-7000 SOM Bd/08_DDR3L_Modules.SchDoc
Rev_A/01_HW/ZYNQ-7000 SOM Bd/09_Connectors.SchDoc
Rev_A/01_HW/ZYNQ-7000 SOM Bd/ZYNQ-7000 SOM Bd.PrjPcb
