Ganghyeok-Lim/Proj-ZYNQ-7000_SOM_Bd/(commit log)

2024-05-03 [HW] Feat : Create Altium project
    [01_Index.SchDoc, 02_Overview.SchDoc, 03_Power.SchDoc, 04_ZYNQ_Power.SchDoc, 05_ZYNQ_Config.SchDoc, 06_ZYNQ_PS.SchDoc, 07_ZYNQ_PL.SchDoc, 08_ZYNQ_DDR.SchDoc]
2024-05-17 [HW] Feat : Complete PCB Artwork
    Complete PCB Artwork & Generate Fabrication Data
    [01_Index.SchDoc, 03_Power.SchDoc, 03_ZYNQ_Power.SchDoc, 04_ZYNQ_Config.SchDoc, 04_ZYNQ_Power.SchDoc, 05_ZYNQ_Config.SchDoc, 05_ZYNQ_PS.SchDoc, 06_ZYNQ_PL.SchDoc]
